PHOL-LABS/C64-Pi1541-III-SMD/C64 Pi1541-III Module Panel SMD/C64 Pi1541-III Module Panel.kicad_pcb

## KiCad design C64 Pi1541-III Module Panel SMD/C64 Pi1541-III Module Panel.kicad_pcb (2026-10-28)

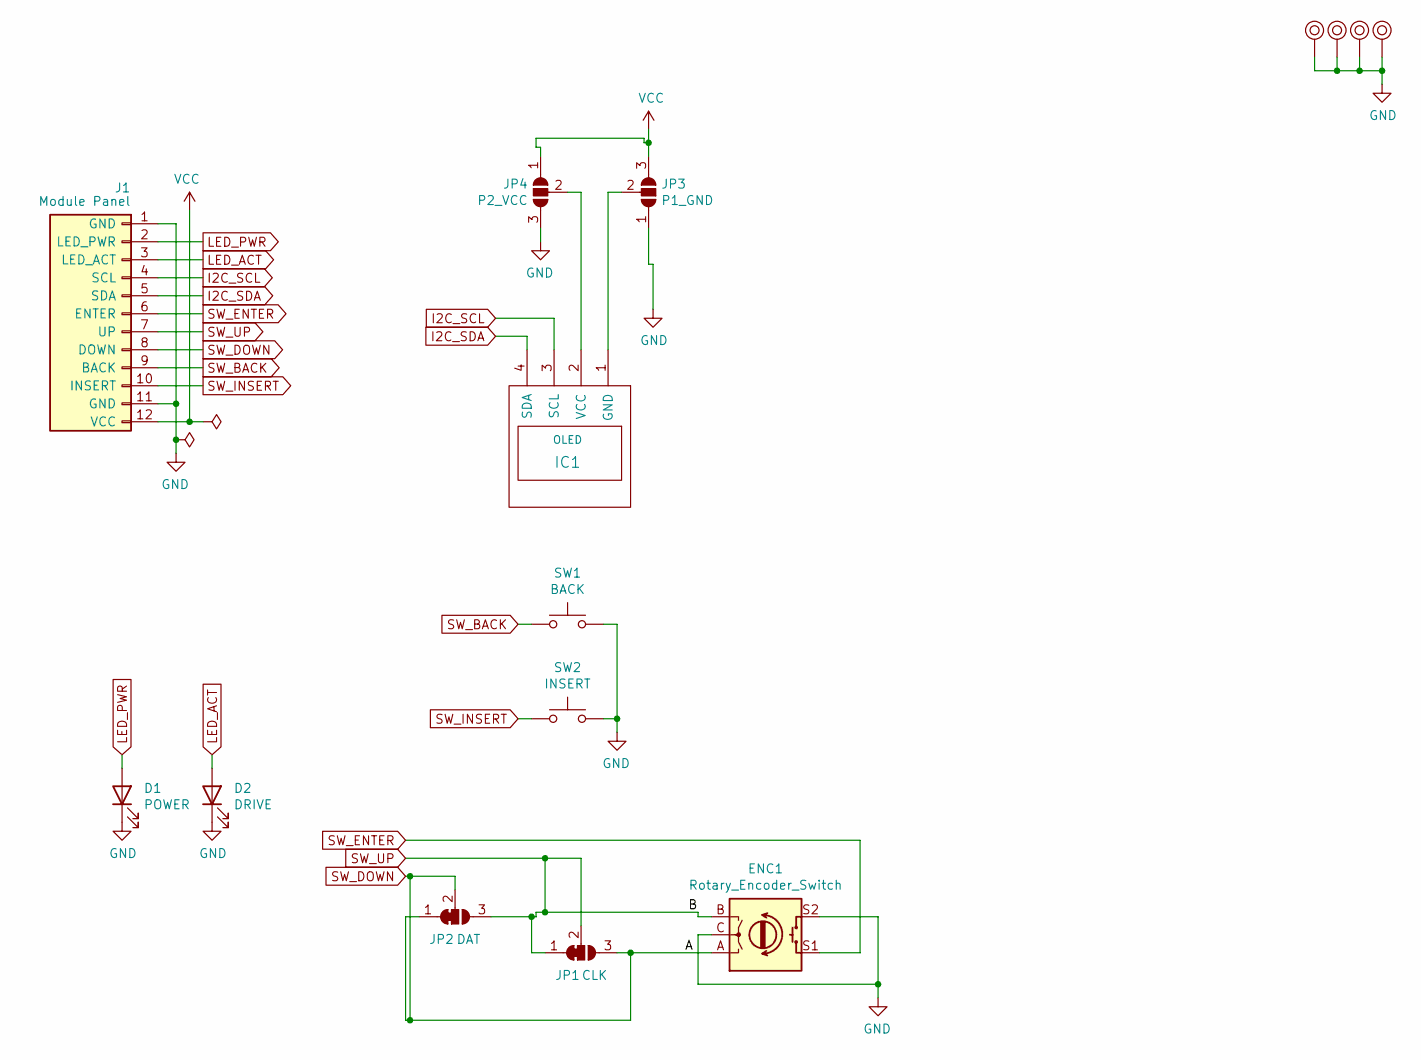
[picture p1: schematic C64 Pi1541-III Module Panel.kicad_sch, C64 Pi1541-III Module Module (Panel)]

Parts:
D1: POWER; LED_1206_3216Metric_Pad1.42x1.75mm_HandSolder
D2: DRIVE; LED_1206_3216Metric_Pad1.42x1.75mm_HandSolder
ENC1: Rotary_Encoder_Switch; RotaryEncoder_Alps_EC11E-Switch_Vertical_H20mm
IC1: OLED; 1.3_I2C_OLED_No_mounting
J1: Module Panel; PinHeader_1x12_P2.54mm_Horizontal
JP1: CLK; SolderJumper-3_P1.3mm_Open_Pad1.0x1.5mm
JP2: DAT; SolderJumper-3_P1.3mm_Open_Pad1.0x1.5mm
JP3: P1_GND; SolderJumper-3_P1.3mm_Open_Pad1.0x1.5mm
JP4: P2_VCC; SolderJumper-3_P1.3mm_Open_Pad1.0x1.5mm
M1, M2, M3, M4: Mounting_Pin; M3_pin
SW1: BACK; SW_SPST_PTS645
SW2: INSERT; SW_SPST_PTS645

Connections:
GND: D1.1 (K), D2.1 (K), ENC1.C, ENC1.S2, J1.1 (GND), J1.11 (GND), JP3.1 (A), JP4.3 (B), M1.1, M2.1, M3.1, M4.1, SW1.2, SW2.2
I2C_SCL: IC1.3 (SCL), J1.4 (SCL)
I2C_SDA: IC1.4 (SDA), J1.5 (SDA)
LED_ACT: D2.2 (A), J1.3 (LED_ACT)
LED_PWR: D1.2 (A), J1.2 (LED_PWR)
unnamed: IC1.1 (GND), JP3.2 (C)
unnamed: IC1.2 (VCC), JP4.2 (C)
SW_BACK: J1.9 (BACK), SW1.1
SW_DOWN: ENC1.A, J1.8 (DOWN), JP1.3 (B), JP2.1 (A), JP2.2 (C)
SW_ENTER: ENC1.S1, J1.6 (ENTER)
SW_INSERT: J1.10 (INSERT), SW2.1
SW_UP: ENC1.B, J1.7 (UP), JP1.1 (A), JP1.2 (C), JP2.3 (B)
VCC: J1.12 (VCC), JP3.3 (B), JP4.1 (A)

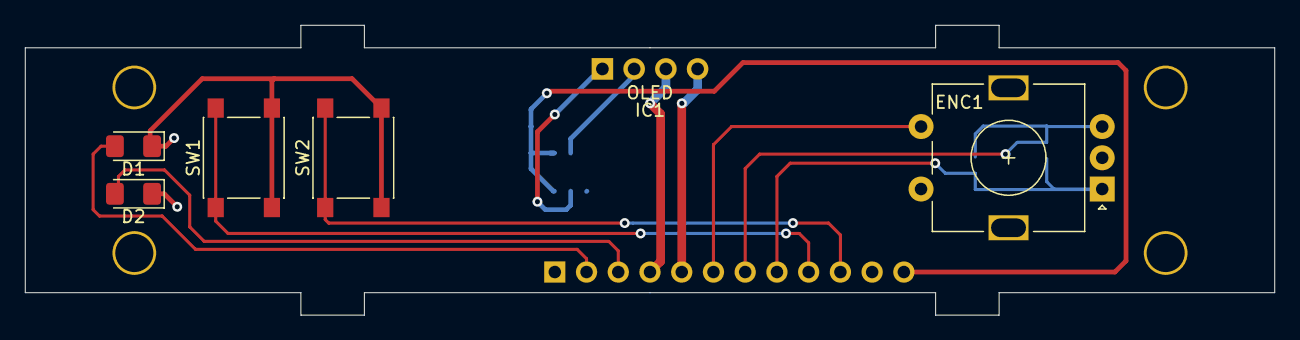
[picture p2: board C64 Pi1541-III Module Panel.kicad_pcb from above]

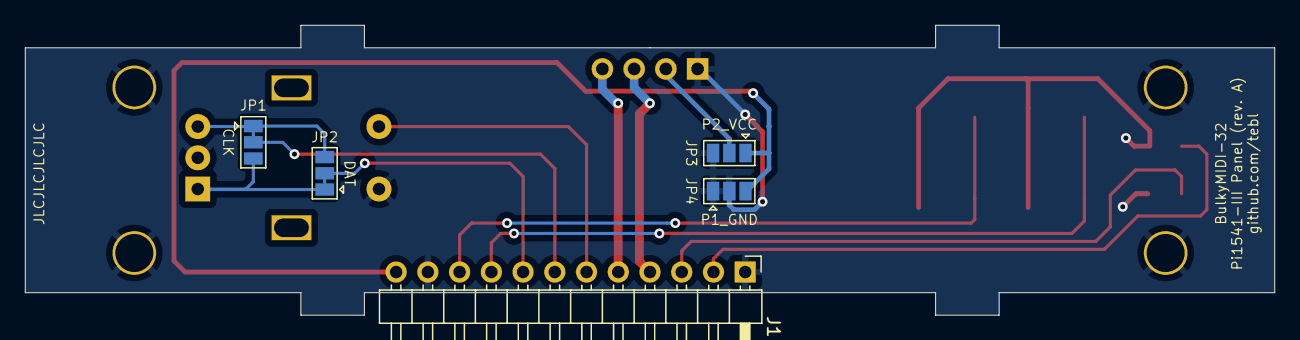
[picture p3: board C64 Pi1541-III Module Panel.kicad_pcb from below]

Board: 2 copper layers, 100.0 x 23.2 mm, 15 parts (5 on the bottom side), 13 nets.
